Edw590/Linear-30V-3A-DC-PSU/Pictures/Oscilloscope/18 V rail with fan connected; 0.2V, 5ms, AC.jpg

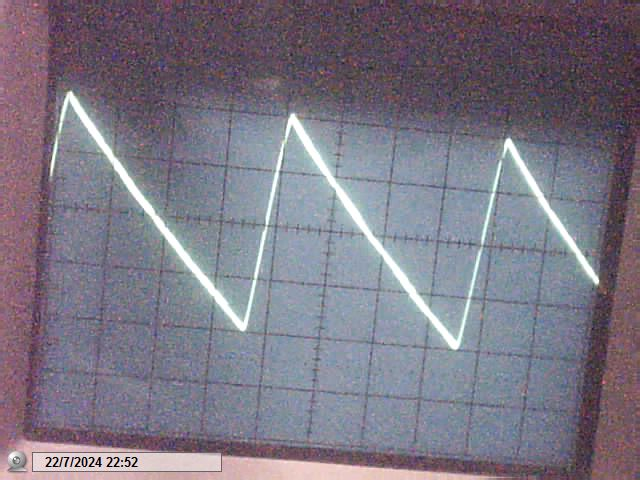
Pictures/Oscilloscope/18 V rail with fan connected; 0.2V, 5ms, AC.jpg
