Edw590/Linear-30V-3A-DC-PSU/Pictures/IMG_20220613_202030_4.jpg

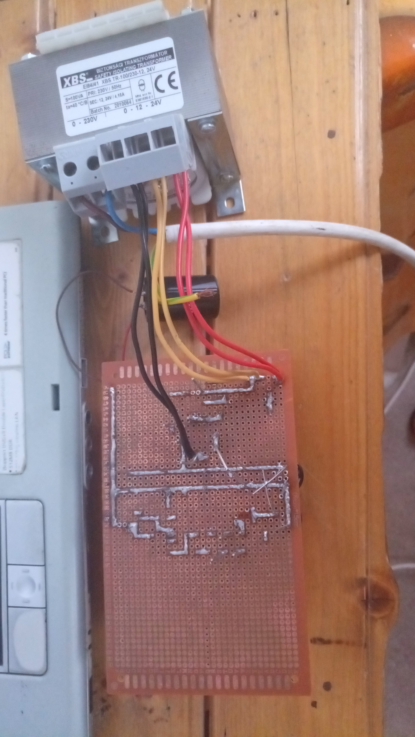
Pictures/IMG_20220613_202030_4.jpg
