Edw590/Linear-30V-3A-DC-PSU/Perfboard drawings/1st board.png

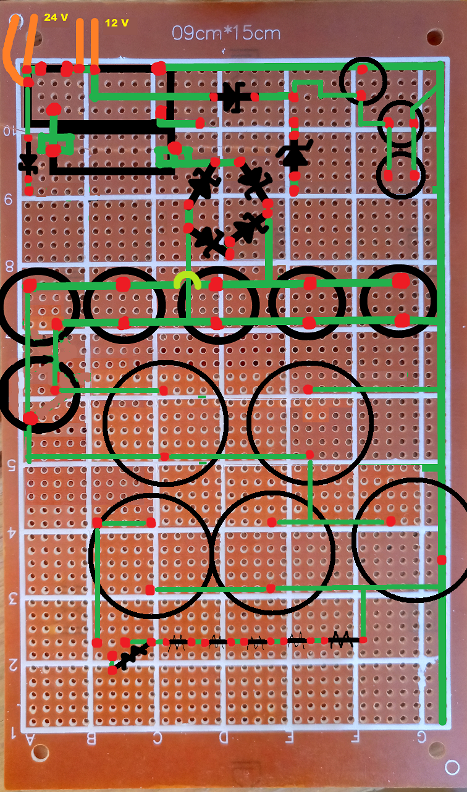
Perfboard drawings/1st board.png
