Edw590/Linear-30V-3A-DC-PSU/Perfboard drawings/2nd board.jpg

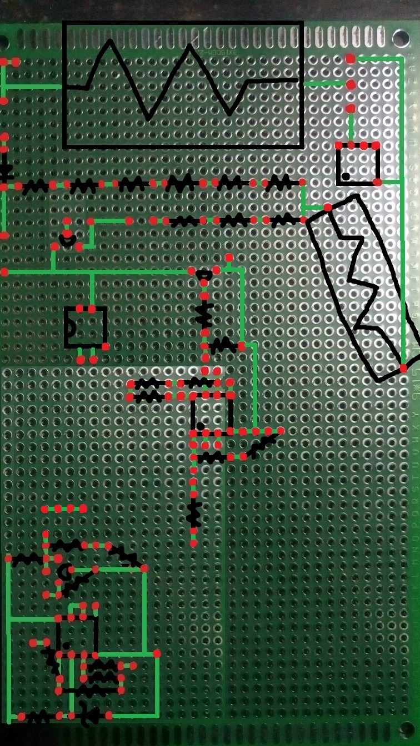
Perfboard drawings/2nd board.jpg
