Edw590/Linear-30V-3A-DC-PSU/Perfboard drawings/IMG_20240725_204748_0.jpg

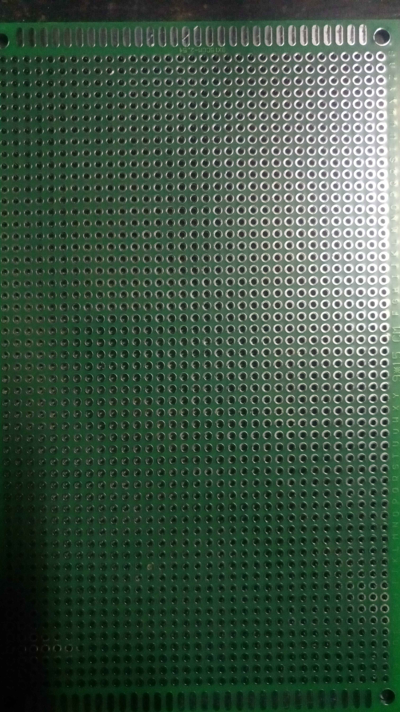
Perfboard drawings/IMG_20240725_204748_0.jpg
