Edw590/Linear-30V-3A-DC-PSU/Pictures/PSU after drilling.jpg

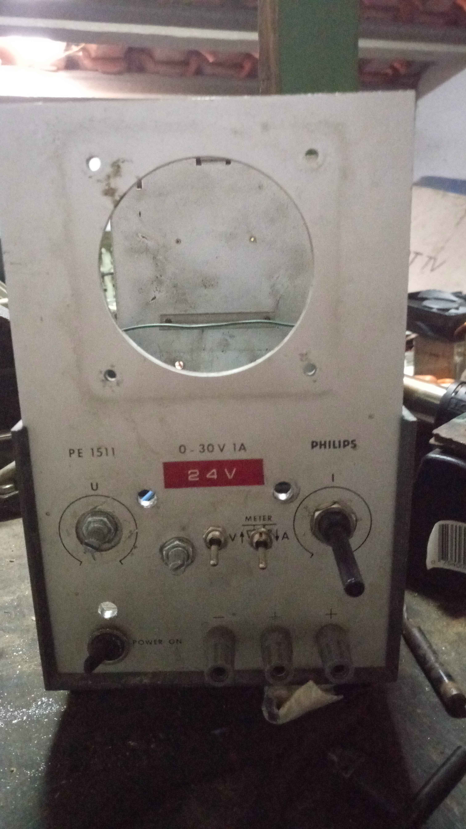
Pictures/PSU after drilling.jpg
