Edw590/Linear-30V-3A-DC-PSU/Pictures/PSU.jpg

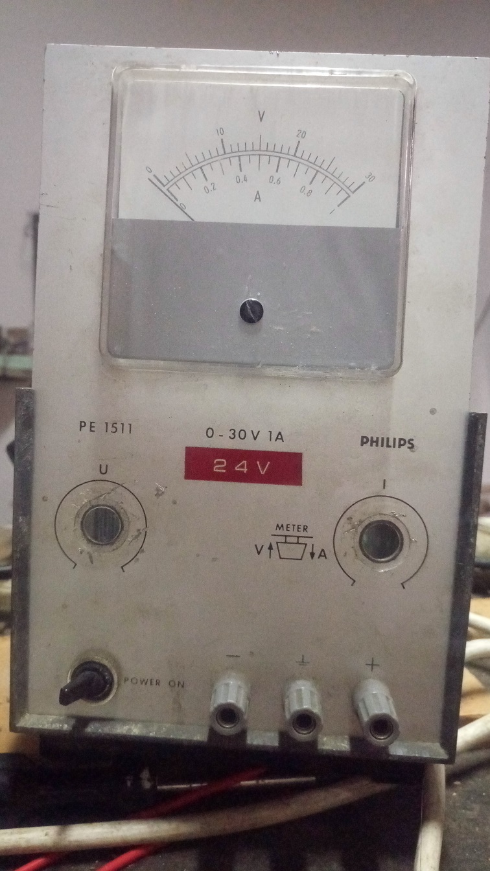
Pictures/PSU.jpg
