Edw590/Linear-30V-3A-DC-PSU/Relay test.asc

R1: res; 1k
RelS1: sw; SwNC
RelS2: sw; SwNO
V1: voltage; SINE(0 12 50)
V2: voltage; SINE(0 12 50)
V3: voltage; PULSE(0 15 0 0 0 0.001 0.002)
Named nets: 0, OUT, IN++, IN+, Comp
Relay
NC
NO
Relay
.tran 100m
; For the relays
.MODEL SwNO SW(Ron=10m Roff=1000Meg Vt=12 Vh=.5 Lser=10n Vser=.6)
.MODEL SwNC SW(Roff=10m Ron=1000Meg Vt=0.5 Vh=.5 Lser=10n Vser=.6)
