Edw590/Linear-30V-3A-DC-PSU/PSU.asc

C1: polcap; 45m; V=35 Irms=3.355 Rser=0.004 Lser=14.3824n
C2: cap; 10m; V=35
C4: cap; 3m; V=35
D1: schottky; B560C
D2: schottky; B560C
D3: schottky; B560C
D4: schottky; B560C
D5: schottky; B560C
D6: schottky; B560C
D7: diode; 1N4148
D8: zener; UMZ5_1N
D12: zener; BZX84C15L
D13: schottky; B560C
L1: ind2; 270
L2: ind2; 1
L3: ind2; 1
LED1: LED; LXK2-PW14
LED2: LED; LXK2-PW14
LED3: LED; LXK2-PW14
LED4: LED; LXK2-PW14
Q1: npn; TIP33C
Q2: npn; 2N2222
Q3: npn; TIP142
Q4: npn; 2N2222
Q7: npn; 2N2222
R1: res; 0.001
R2: res; 0.001
R2_B: res; 1.2k
R3: res; 2k
R4: res; 20k
R5: res; 10000000Meg
R6: res; 1k
R7: res; 20k
R8: res; 100k
R9: res; 47
R10: res; 1.2k
R11: res; 2k
R12: res; 10k
R13: res; 0.001
R14: res; 1.2k
R15: res; 400k
R16: res; 985
R17: res; 23k
R18: res; 313k
R19: res; 1.2k
R20: res; 1.2k
R21: res; 1.2k
R22: res; 2.45k
R23: res; 1.2k
R24: res; 2k
R25: res; 1.2k
R51: res; 0.001
R_Fan: res; 71
R_Meter1: res; 691
R_Meter2: res; 691
R_Pot1: res; 20k
R_Pot2_1: res; 10k
R_Pot2_2: res; 0
R_Pot3: res; 2.5k
RelS1: sw; SwNO
RelS2: sw; SwNC
RelS5: sw; SwNC
RelS6: sw; SwNO
RL1: res; 25
RL2: res; 200
Rsense: res; 0.1
U1: LM358_AB
U2: LM358_AB
U3: LM358_AB
U4: LM358_TI; LM6171A/NS
U5: LM358_AB
U6: LM358_AB
U7: LM317-1
U8: TL431
U9: LM358_TI; LM6171A/NS
V1: voltage; SINE(0 325.57 50); AC 230 0; Rser=0.1
V2: voltage; PULSE(12.5 0 0 0 0 0.1 0.2)
V3: voltage; SINE(0 10 500 0 0 1); Rser=0.1
Named nets: 0, IN+, OUT+, CmpOut1, IN-, +15V, +18V, +5V, Vref, CmpOut2, +31V, VrefUVP, Vunreg, OUT-
.tran 0.25
K1 L1 L2 L3 1
; For the relays
.MODEL SwNO SW(Ron=10m Roff=1000Meg Vt=12 Vh=.5 Lser=10n Vser=.6)
.MODEL SwNC SW(Roff=10m Ron=1000Meg Vt=0.5 Vh=.5 Lser=10n Vser=.6)
**************************************
*      Model Generated by MODPEX     *
*Copyright(c) Symmetry Design Systems*
*         All Rights Reserved        *
*    UNPUBLISHED LICENSED SOFTWARE   *
*   Contains Proprietary Information *
*      Which is The Property of      *
*     SYMMETRY OR ITS LICENSORS      *
*    Modeling services provided by   *
* Interface Technologies www.i-t.com *
**************************************
.SUBCKT TIP142 1 2 3
* Model generated on Feb  8, 2004
* Model format: PSpice
* Darlington macro model
* External node designations
* Node 1 -> Collect
* Node 2 -> Base
* Node 3 -> Emitter
Q1 1 2 4 qmodel
Q2 1 4 3 q1model 19.6725
D1 3 1 dmodel
R1 2 4 8000
R2 4 3 40
* Default values used in dmodel
*   EG=1.11 TT=0 BV=infinite
.MODEL dmodel d
+IS=1e-12 RS=10 N=1 XTI=3
+CJO=0 VJ=0.75 M=0.33 FC=0.5
.MODEL qmodel npn
+IS=2.92836e-16 BF=233.76 NF=1.2 VAF=1000
+IKF=0.222129 ISE=4.61322e-11 NE=2.48158 BR=1.89854
+NR=0.75 VAR=168.458 IKR=0.108495 ISC=9.99999e-14
+NC=2.00001 RB=7.90758 IRB=0.2 RBM=7.90758
+RE=0.275456 RC=1.42279 XTB=0.232595 XTI=3.02293 EG=1.206
+CJE=1e-11 VJE=0.75 MJE=0.33 TF=1e-09
+XTF=1 VTF=10 ITF=0.01 CJC=1.67157e-09
+VJC=0.95 MJC=0.23 XCJC=0.9 FC=0.5
+TR=1e-07 PTF=0 KF=0 AF=1
.MODEL q1model npn
+IS=2.92836e-16 BF=233.76 NF=1.2 VAF=1000
+IKF=0.222129 ISE=4.61322e-11 NE=2.48158 BR=1.89854
+NR=0.75 VAR=168.458 IKR=0.108495 ISC=9.99999e-14
+NC=2.00001 RB=7.90758 IRB=0.2 RBM=7.90758
+RE=0.275456 RC=1.42279 XTB=0.232595 XTI=3.02293 EG=1.206
+CJE=1e-11 VJE=0.75 MJE=0.33 TF=1e-09
+XTF=1 VTF=10 ITF=0.01 CJC=0
+VJC=0.95 MJC=0.23 XCJC=0.9 FC=0.5
+TR=1e-07 PTF=0 KF=0 AF=1
.ENDS
Relay
NTCR1
Diode here to protect from the coil's back "infinite" EMF
NC
NO
Undervoltage protection (also SCP)
18 - 5 = 13 V --> Fan voltage
Unregulated module
*//////////////////////////////////////////////////////////////////////
* (C) National Semiconductor, Inc.
* Models developed and under copyright by:
* National Semiconductor, Inc.  
*/////////////////////////////////////////////////////////////////////
* Legal Notice: This material is intended for free software support.
* The file may be copied, and distributed; however, reselling the 
*  material is illegal
*////////////////////////////////////////////////////////////////////
* For ordering or technical information on these models, contact:
* National Semiconductor's Customer Response Center
*                 7:00 A.M.--7:00 P.M.  U.S. Central Time
*                                (800) 272-9959
* For Applications support, contact the Internet address:
*  Appshelp@galaxy.nsc.com
*/////////////////////////////////////////
*LM6171A Operational Amplifier Macro-Model
*/////////////////////////////////////////
*
*Connections       non-inverting input
*                  | inverting input
*                  | |  positive power supply
*                  | | |  negative power supply
*                  | | | |  output
*                  | | | | |
.SUBCKT LM6171A/NS 3 2 4 5 6
* CAUTION:  SET .OPTIONS GMIN=1E-16 TO CORRECTLY MODEL INPUT BIAS CURRENT.
* Features:
* +/-15V Operation
* Unity Gain Stable
* Offset voltage (max) =             3mV
* Gain-bandwidth product =           100 MHz 
* Supply current =                   2.5mA
* Slew rate =                        3600V/uS
* Open Loop gain =                   90dB
********************************************************************
EOX 120 10 31 32 2.0
RCX 120 121 1K
RDX 121 10 1K
RBX 120 122 1K
GOS 10 57 122 121 1.0
RVOS 31 32 1K
RINB 2 18 1000
RINA 3 19 1000
DIN1 5 18 DMOD2
DIN2 18 4 DMOD2
DIN3 5 19 DMOD2
DIN4 19 4 DMOD2
EXX 10 5 17 5 1.0
EEE 10 50 17 5 1.0
ECC 40 10 4 17 1.0
RAA 4 17 100MEG
RBB 17 5 100MEG
ISET 10 24 1e-3
DA1 24 23 DMOD1
RBAL 23 22 1000
ESUPP 22 21 4 5 1.0
VOFF 21 10 -1.25
DA2 24 25 DMOD1
VSENS1 25 26 DC 0
RSET 26 10 1K
CSET 26 10 1e-10
FSET 10 31 VSENS1 1.0
R001 34 10 1K
FTEMP 10 27 VSENS1 1.0
DTA 27 10 DMOD2
DTB 28 29 DMOD2
VTEMP 29 10 DC 0
ECMR 38 10 11 10 1.0
VCMX 38 39 DC 0
RCM2 41 10 1MEG
EPSR 42 10 4 10 1.0
CDC1 43 42 10U
VPSX 43 44 DC 0
RPSR2 45 10 1MEG
FCXX 57 10 VCXX 100
DCX1 98 97 DMOD1
DCX2 95 94 DMOD1
RCX1 99 98 100
RCX2 94 99 100
VCXX 99 96 DC 0
ECMX 96 10 11 10 1.0
DLIM1 52 57 DMOD1
DLIM2 57 51 DMOD1
ELIMP 51 10 26 10 99.3
GDM 10 57 3 2 1
C1 58 59 1e-10
DCLMP2 59 40 DMOD1
DCLMP1 50 59 DMOD1
RO2 59 10 1K
GO3 10 71 59 10 1
RO3 71 10 1
DDN1 73 74 DMOD1
DDN2 73 710 DMOD1
DDP1 75 72 DMOD1
DDP2 71 720 DMOD1
RDN2 710 71 100
RDP 720 72 100
VOOP 40 76 DC 0
VOON 77 50 DC 0
QNO 76 73 78 NPN1
QNP 77 72 79 PNP1
RNO 78 81 1
RPO 79 81 1
VOX 86 6 DC 0
RNT 76 81 100MEG
RPT 81 77 1MEG
FX 10 93 VOX 1.0
DFX1 93 91 DMOD1
VFX1 91 10 DC 0
DFX2 92 93 DMOD1
VFX2 10 92 DC 0
FPX 4 10 VFX1 1.0
FNX 10 5 VFX2 1.0
RAX 122 10 MRAX 1.006000e+03
.MODEL MRAX RES (TC1=-1.1e-05)
FIN1 18 5 VTEMP 0.985
FIN2 19 5 VTEMP 1.015
CIN1 2 10 1e-12
CIN2 3 10 1e-12
RD1 18 11 2.45e+06
RD2 19 11 2.45e+06
RCM 11 10 3.8775e+07
FCMR 10 57 VCMX 3.16228
FPSR 10 57 VPSX 63.2456
RSLOPE 4 5 33333.3
GPWR 4 5 26 10 0.0016
ETEMP 27 28 32 33 0.178427
RIB 32 33 MRIB 1K
.MODEL MRIB RES (TC1=0.00389579)
RISC 33 34 MRISC 1K
.MODEL MRISC RES (TC1=-0.002)
RCM1 39 41 10
CCM 41 10 2.65258e-11
RPSR1 44 45 100
CPSR 45 10 1.59155e-10
ELIMN 10 52 26 10 91.8926
RDM 57 10 23.5073
C2 57 10 4.78743e-11
ECMP 40 97 26 10 2
ECMN 95 50 26 10 2
G2 58 10 57 10 0.00378
R2 58 10 11.254
GO2 59 10 58 10 35
EPOS 40 74 26 10 1.4
ENEG 75 50 26 10 1.5
GSOURCE 74 73 33 34 0.00135
GSINK 72 75 33 34 0.00135
ROO 81 86 13
.MODEL DMOD1 D
*-- DMOD1 DEFAULT PARAMETERS
*IS=1e-14 RS=0 N=1 TT=0 CJO=0
*VJ=1 M=0.5 EG=1.11 XTI=3 FC=0.5
*KF=0 AF=1 BV=inf IBV=1e-3 TNOM=27
.MODEL DMOD2 D  (IS=1e-17)
*-- DMOD2 DEFAULT PARAMETERS
*RS=0 N=1 TT=0 CJO=0
*VJ=1 M=0.5 EG=1.11 XTI=3 FC=0.5
*KF=0 AF=1 BV=inf IBV=1e-3 TNOM=27
.MODEL NPN1 NPN (BF=100 IS=1e-15)
*-- NPN1 DEFAULT PARAMETERS
*NF=1 VAF=inf IKF=inf ISE=0 NE=1.5
*BR=1 NR=1 VAR=inf IKR=inf ISC=0
*NC=2 RB=0 IRB=inf RBM=0 RE=0 RC=0
*CJE=0 VJE=0.75 MJE=0.33 TF=0 XTF=0
*VTF=inf ITF=0 PTF=0 CJC=0 VJC=0.75
*MJC=0.33 XCJC=1 TR=0 CJS=0 VJS=0.75
*MJS=0 XTB=0 EG=1.11 XTI=3 KF=0 AF=1
*FC=0.5 TNOM=27
.MODEL PNP1 PNP (BF=100 IS=1e-15)
*-- PNP1 DEFAULT PARAMETERS
*NF=1 VAF=inf IKF=inf ISE=0 NE=1.5
*BR=1 NR=1 VAR=inf IKR=inf ISC=0
*NC=2 RB=0 IRB=inf RBM=0 RE=0 RC=0
*CJE=0 VJE=0.75 MJE=0.33 TF=0 XTF=0
*VTF=inf ITF=0 PTF=0 CJC=0 VJC=0.75
*MJC=0.33 XCJC=1 TR=0 CJS=0 VJS=0.75
*MJS=0 XTB=0 EG=1.11 XTI=3 KF=0 AF=1
*FC=0.5 TNOM=27
.ENDS
*$
Regulator module
Must be a voltage source for some reason,
not the CmpOut signal
For noise
NC
NO
Relay
8R
Winding switcher circuit
Overcurrent protection (OCP)
Vref<->OUT regulator
"-M" means missing in the physical circuit
*SYM=SCR
*SRC=2N5064;2N5064;SCRs;TECCOR; 200V 0.8A 
.SUBCKT 2N5064   1 2 3
*    TERMINALS:  A G K
QP  6 4 1  POUT OFF
QN  4 6 5  NOUT OFF
RF  6 4    400K
RR  1 4    267K
RGK 6 5    80
RG  2 6    9.09
RK  3 5    0.112
DF  6 4    ZF
DR  1 4    ZR
DGK 6 5    ZGK
.MODEL ZF   D (IS=3.2E-16 IBV=100U BV=200)
.MODEL ZR   D (IS=3.2E-16 IBV=100U BV=200)
.MODEL ZGK  D (IS=3.2E-16 IBV=100U BV=5)
.MODEL POUT PNP (IS=320F BF=1 CJE=402P TF=102U)
.MODEL NOUT NPN (IS=320F BF=100 RC=0.45 CJE=2.01N CJC=402P TF=3.74U)
.ENDS
1N5338B
BDY20
Button (to force disable the
protection after it's triggered)
Switch here
.MODEL TIP33C npn
+IS=1e-09 BF=2530.91 NF=0.026029 VAF=10
+IKF=0.0647102 ISE=1.00058e-09 NE=1.836 BR=0.1
+NR=1.5 VAR=100 IKR=0.647102 ISC=1.00058e-09
+NC=1.45279 RB=6.98719 IRB=6.81966 RBM=0.001
+RE=0.0001 RC=0.0636828 XTB=15.7688 XTI=1
+EG=1.05 CJE=3.26476e-10 VJE=0.446174 MJE=0.464223
+TF=2.062e-09 XTF=15.0842 VTF=25.7317 ITF=0.001
+CJC=3.07593e-10 VJC=0.775484 MJC=0.476498 XCJC=0.750493
+FC=0.796407 CJS=0 VJS=0.75 MJS=0.5
+TR=1e-07 PTF=0 KF=0 AF=1
LM358
Switch to choose between position R_Meter1 or R_Meter2
