Edw590/Linear-30V-3A-DC-PSU/A2.asc

C1: cap; 470µ
C1_A: polcap; 40m; V=50 Irms=3.355 Rser=0.004 Lser=14.3824n mfg="Würth Elektronik" pn="860010683032 WCAP-ATG8 22x41" type="Al electrolytic"
C2: cap; 470µ
C3: cap; 470µ
C4: cap; 470µ
D1: schottky; RB095T-90
D2: schottky; RB095T-90
D3: schottky; RB095T-90
D4: schottky; RB095T-90
D5: zener; 1N750
D6: zener; 1N750
D7: diode; 1N4148
D8: schottky; RB095T-90
D10: diode; 1N4148
D11: zener; UMZ5_1N
D12: zener; MMBZ6V8ALY
D13: schottky; RB095T-90
L1: ind2; 367.36
L2: ind2; 1
L3: ind2; 1
NTCR1: ntc_resistor; R0=8
Q1: npn; BC547B
Q1_B: npn; TIP41C
Q2: npn; BC547B
Q2_B: npn; 2N2222
Q3: npn; TIP41C
Q3_B: npn; 2N2222
Q4: npn; TIP41C
Q5: npn; TIP41C
Q6: npn; TIP41C
Q7: npn; TIP41C
R1: res; 0.001
R1_Pot: res; 20k
R2: res; 0.001
R2_B: res; 800
R2_Pot: res; 800
R3: res; 2k
R3_B: res; 3.9k
R4: res; 20k
R4_B: res; 860
R5: res; 10000000Meg
R5_B: res; 0.36
R6: res; 20k
R6_B: res; 0.90
R7: res; 25
R7_B: res; 1k
R8: res; 20k
R8_B: res; 10k
R9: res; 20k
R10: res; 20k
R11: res; 40k
R12: res; 100m
R13: res; 100m
R14: res; 100m
R15: res; 100m
R16: res; 100m
R17: res; 100m
R18: res; 0.001
R22: res; 7
R_Fan: res; 71
RelS1: sw; SwNO
RelS2: sw; SwNC
RelS3: sw; SwNC
RelS4: sw; SwNO
Rout: res; 0.001
S3: sw; SwNO
U1: LM358_TI
U2: LM358_TI
U4: tlv431
V1: voltage; SINE(0 325.57 50); AC 230 0; Rser=0.1
V3: voltage; SINE(0 10 5000); Rser=0.1
Named nets: 0, V637, V638, V639, Vunreg, IN+, OUT, CmpOut, IN-, +16V, +34V, +5V, ShortDetec, +17V, +1.24V
.tran 0.35
K1 L1 L2 L3 1
; For the relays
.MODEL SwNO SW(Ron=10m Roff=100Meg Vt=3 Vh=-.5 Lser=10n Vser=.6)
.MODEL SwNC SW(Roff=10m Ron=100Meg Vt=3 Vh=-.5 Lser=10n Vser=.6)
**************************************
*      Model Generated by MODPEX     *
*Copyright(c) Symmetry Design Systems*
*         All Rights Reserved        *
*    UNPUBLISHED LICENSED SOFTWARE   *
*   Contains Proprietary Information *
*      Which is The Property of      *
*     SYMMETRY OR ITS LICENSORS      *
*    Modeling services provided by   *
* Interface Technologies www.i-t.com *
**************************************
.SUBCKT TIP142 1 2 3
* Model generated on Feb  8, 2004
* Model format: PSpice
* Darlington macro model
* External node designations
* Node 1 -> Collect
* Node 2 -> Base
* Node 3 -> Emitter
Q1 1 2 4 qmodel
Q2 1 4 3 q1model 19.6725
D1 3 1 dmodel
R1 2 4 8000
R2 4 3 40
* Default values used in dmodel
*   EG=1.11 TT=0 BV=infinite
.MODEL dmodel d
+IS=1e-12 RS=10 N=1 XTI=3
+CJO=0 VJ=0.75 M=0.33 FC=0.5
.MODEL qmodel npn
+IS=2.92836e-16 BF=233.76 NF=1.2 VAF=1000
+IKF=0.222129 ISE=4.61322e-11 NE=2.48158 BR=1.89854
+NR=0.75 VAR=168.458 IKR=0.108495 ISC=9.99999e-14
+NC=2.00001 RB=7.90758 IRB=0.2 RBM=7.90758
+RE=0.275456 RC=1.42279 XTB=0.232595 XTI=3.02293 EG=1.206
+CJE=1e-11 VJE=0.75 MJE=0.33 TF=1e-09
+XTF=1 VTF=10 ITF=0.01 CJC=1.67157e-09
+VJC=0.95 MJC=0.23 XCJC=0.9 FC=0.5
+TR=1e-07 PTF=0 KF=0 AF=1
.MODEL q1model npn
+IS=2.92836e-16 BF=233.76 NF=1.2 VAF=1000
+IKF=0.222129 ISE=4.61322e-11 NE=2.48158 BR=1.89854
+NR=0.75 VAR=168.458 IKR=0.108495 ISC=9.99999e-14
+NC=2.00001 RB=7.90758 IRB=0.2 RBM=7.90758
+RE=0.275456 RC=1.42279 XTB=0.232595 XTI=3.02293 EG=1.206
+CJE=1e-11 VJE=0.75 MJE=0.33 TF=1e-09
+XTF=1 VTF=10 ITF=0.01 CJC=0
+VJC=0.95 MJC=0.23 XCJC=0.9 FC=0.5
+TR=1e-07 PTF=0 KF=0 AF=1
.ENDS
Notice that put the protections makes the TIP current be stolen and VCE != 0
always (which means, less output voltage, even without an overload).
PS: happens with any of the 2 protections.
Above, a pull-down resistor so that the signal is not floating at t=0
ATTENTION: as said on Discord, there can be drifts in the reference voltage depending
on the ripple from the unregulated supply. Check if with the ripple being at most 3 V it's too
bad or if we really must use an IC as a fixed DC PSU for the comparator.
Note: say on the DOCX that you changed your mind because of this.
Relay
NTCR1
Diode here to protect from the coil's back "infinite" EMF
NC
NO
Relay
NC
NO
Mechanical switch to toggle short-circuit protection
So no need for Foldback protection anymore - protection for overcurrent only
Try to put a switch here too, and glue to the upper one so that both are controlled at the
same time. This way, the relay is bypassed and also disabled (why wear it out if it's not being
used anyway?).
Put this in the unregulated part - cut the maximum power possible
SCHMITT TRIGGER NEEDED HERE!!!!!!!!!!!
This is just on paper. In practice, the 17 V rail must be given, as it's more stable than
the 5 V one (depends on the fan) - also because in practice, the LMV431 will be
used, which can withstand up to 35 V (recommended 30 V).
EDIT: unless the 5 V rail is more stable than the 17 V one (check with the scope, not here).
Find another transistor with lower VBE (this one is 1.7 V...), and keep the gain high
(no darlington pair needed then, which would get another VBE into account).
7.5 Ohm minimum (30 V/4 A)
Except voltage gets lowered. Test manually at 4 A.
Currently (2022-10-27): 7 Ohm
The relation of this is not linear!!! FIX THAT
You can't put 0 on the bottom. The potentiometer must be on one side only.
Else, weird relation (try to make an equation just for curiosity of the relation?)
.MODEL TIP41C npn
+IS=7.55826e-11 BF=260.542 NF=1.11221 VAF=100
+IKF=0.526814 ISE=1e-08 NE=2.18072 BR=26.0542
+NR=1.5 VAR=1000 IKR=3.54059 ISC=1e-08
+NC=1.63849 RB=4.56157 IRB=0.1 RBM=0.1
+RE=0.0162111 RC=0.0810556 XTB=0.1 XTI=1
+EG=1.206 CJE=1.93296e-10 VJE=0.4 MJE=0.259503
+TF=1e-08 XTF=4.06972 VTF=7.1157 ITF=0.001
+CJC=1.09657e-10 VJC=0.730921 MJC=0.23 XCJC=0.803085
+FC=0.8 CJS=0 VJS=0.75 MJS=0.5
+TR=9.01013e-08 PTF=0 KF=0 AF=1
* Model generated on Dec 27, 2003
* Model format: PSpice
