Edw590/Linear-30V-3A-DC-PSU/(commit log)

2024-03-01 Match between LTspice and actual circuit
    Now both places match. There are components missing which have "-M"
    appended to them on LTspice.
    The circuit on LTspice should be ready to be continued to part B, the
    regulated part of the PSU.
2024-03-05 Regulator module development begun
    List of changes:
    - Parallel of 3 capacitors removed and repurposed to the 17 and 34 V
    rails.
    - More components missing noted down.
    - Regulator module development begun and some components are now
    properly placed.
2024-03-08 Overload and short-circuit protection added
    List originf changes:
    - Circuit works with LTspice 24 (the power diodes weren't supported in
    the new one).
    - Overcurrent protection added with variable limit chosen by a
    potentiometer.
    - Short-circuit protection made up by me added. It checks if the output
    voltage is below half the reference voltage and if so, it turns off
    the output. It needs a switch to reset the protection.
    - The potentiometer that chooses the output voltage is now on the
    reference voltage instead of on the output. This removes the
    possibility of current flowing through the voltage divider on the
    output - now there's none. This also means the TLV431 now goes from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
2024-03-08 Power diodes changed to better match bought ones
2024-03-09 Test with winding relay switching
2024-03-09 Short-circuit protection improved, relays fixed
    - Short-circuit protection improved to now using a relay instead of
    stopping the power transistors (useful in case they get burned and
    shorted). It also detects now at 2/3 of Vref instead of 1/2.
    - Fixed the relays not working and now both can be tested. One of them
    needs a voltage source on the simulation for some reason, but the
    overall result is that it works. The 2nd one works perfectly.
    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
2024-03-09 Short-circuit protection has choosable level / off
    Now there's a potentiometer choosing the short-circuit protection level.
    It can also be turned off and so there's no short-circuit protection.
2024-03-09 Almost fixed winding switch supply rail
    Can't use the +34V one because LTspice doesn't like it. I'll try again
    with more changes to the circuit. Maybe they make LTspice like
    simulating this.
2024-03-09 Schmitt trigger added to the winding switcher
    Supposedly it'll go high at 14+1.7 V and will go low at 14-1.7 V. Needs
    physical testing to be sure but should be working.
2024-03-10 2nd relay now is always on GND by default
    This protects the load in case there's a malfunction in the supply - the
    load will have no power by default.
    There's also a pull-up resistor on the SC protection because of that
    (explanation is on the schematic).
    Also changed the noise voltage source to 500 Hz instead of 5 kHz,
    because it's more realistic.
2024-03-10 Maximum current changed to 2.88 A
    After reviewing the datasheet of the transformer, it can take up to 2.95
    A on both windings after rectification. So the maximum was changed to a
    bit below that.
2024-03-10 Schmitt trigger hysteresis width changed to 1.7 V
2024-03-11 Changed NTC resistor and LM358 connected to +34V
2024-03-12 Undo connect LM538 to +34V - still causes DefCon 1
2024-03-12 Correct mistaken SCP initial start
    The SCP would start when the circuit would be turned on. That doesn't
    happen anymore now, with the addition of the capacitor C5. The
    explanation is on the DOCX.
2024-03-12 Overvoltage protection added
    If the power transistors get shorted, full voltage will appear on the
    output - this disables the supply in that case.
2024-03-13 SCP and OVP corrected to not rely on a relay
    As explained on Discord, the relay contacts will get welded at such high
    currents in case of OVP, and it's just too slow in both cases (can take
    10ms to switch and apparently that's too long already).
    Instead, the SCP is now stealing the current from the pass transistors,
    and the OVP is using a thyristor to short the output and allow the fuse
    to blow to protect the circuit.
2024-03-14 Schmitt trigger width corrected from 1.7 V to 3.4 V
2024-03-17 Noted LM6171 in 2 places and R to limit LM358 curr
    Now the SCR current is no longer a problem - it's an LM6171 providing
    the current, which can give up to 135 mA and that's more than enough
2024-07-13 Crowbar removed, passive averager added
    - Crowbar circuit removed. I'll let the fuse do its job instead. As I
    was told on Discord, shorted pass transistor is an emergency and the
    supply can't work without it, so just blow the fuse and make the user
    replace the transistor.
    - Added a passive averager to sum the currents from the comparator 1 and
    2 and feed to Q7. This is an analog OR circuit. Any of the protections
    are triggered, the transistor will start conducting.
    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
2024-07-13 Disabled OVP, added LEDs and button
    The Overvoltage Protection is now useless. The protection is now done by
    the fuse itself.
2024-07-13 Added LED to OCP
2024-07-14 Correct LEDs and an LED direction
2024-07-14 Precision Vref added, discharge resistor added
    Now Vref can go down to 0.125 V - with a switch. Precision mode.
    Need for LM6171 removed on the regulator. It's driving a darlington pair
    so no need for a more powerful op amp.
2024-07-14 Overvoltage protection circuit removed
2024-07-14 Replaced 3 diodes by one 15 V Zener
2024-07-17 Add 15 mF cap, add analog meter voltage divider
    15 mF cap on the 34 V rail now, because various parts draw current from
    it, and added a voltage divider necessary for an old analog meter I got
    to show the correct voltage on it
2024-07-18 Added caps discharging circuit instead of resistor
    And it's fast enough to discharge in 2.1 seconds from 30 V to 0 V.
2024-07-18 Removed darlington pair and OCP LED
    The LED was making the OCP minimum be higher. The LM6171 can provide
    enough current to power the BDY20 through the 2.7 A, so no need for a
    darlington pair.
2024-07-19 Some transistors replaced by 2N2222 and TIP33C
    The BC547B has as maximum collector current of 100 mA and I need at
    least 136 mA, so I replaced it by a 2N2222.
    The TIP142 doesn't simulate too well the BDY20 that will be used in the
    actual circuit (VCEsat is too high), so I replaced it by a TIP33C.
2024-07-19 Capacitor removed from the SCP
    Now it's instantaneous - one just needs to be aware it will be triggered
    when the PSU starts or in some other cases. We'll see if I get it back
    there or not.
2024-07-20 Now using TL431 instead of TLV431
    I found a TL431A (1% precision). That's better than the LMV431CZ I was
    gonna get (1.5% precision). So now the supposed minimum voltage is 2.5
    V instead of 1.24 V (except it can go lower with the voltage divider)
2024-07-20 New OCP able to limit from 0 mA onwards
    Only problem is I don't have a 1.2k potentiometer, so I'll have to use a
    1k one and have a 240 Ohm resistor in series with it - which limits the
    minimum current limiting to around 500 mA. Could be worse (has been).
2024-07-21 Vref calibrated to 30 V max now
2024-07-21 Winding switcher circuit removed from perfboard
2024-07-21 OCP changed to another new one, 50mR Ohm to 0R1
    This new one can still go down to 0 mA. The other one needed a negative
    supply of 1-3 V to power the negative rail of the op amp. This new one
    doesn't need that.
    I also changed the sense resistor to 0.1 Ohm instead of 0.05 Ohm.
2024-07-21 Some LM6171 instances replaced by LM358
    Haven't seen any Def Con 1 so they should work. If they don't, I'll
    switch back to LM6171 to stop them as I did before.
2024-07-22 Perfboard synced with physical circuit
2024-07-22 LTspice circuit synced with physical circuit
2024-07-23 Rails voltage increased to match physical trafo
    The transformer outputs 19 V and 38 V apparently. Not what's on the
    specs. So I changed that on LTspice and now more things have to be
    changed too because some components can't handle more than 32 V.
    The output is now on 29.3 V though. That needs to be fixed.
2024-07-23 Mark all wires solder points
2024-07-23 Change Vref rail to 34 V
2024-07-23 Added part of +31V rail to perfboard
    Also drew diodes where they were instead of just lines
2024-07-24 Add 10 mF capacitors to perfboard and resistor
2024-07-24 Removed 34 V rail and reverse polarity diode
2024-07-24 Correct resistors positioning
2024-07-24 Fix Def Con 1 and mark diode as missing
2024-07-25 Sync LTspice circuit with physical circuit
2024-07-26 Add 2nd board picture, still empty
2024-07-26 Update some calculations to address the new 38 V
2024-07-26 OUT+ on winding switcher circuit instead of Vref
2024-07-26 Correct wrong resistor on Vref circuit
2024-07-26 Mark components as not missing and remove 2 wires
2024-07-26 Add winding switcher circuit to perfboard
2024-07-26 Add LED to OCP protection
2024-07-27 Add Vref circuit to perfboard
    Also begin adding SCP circuit too (the usage of the upper op amp on the
    lower LM358).
2024-07-27 Add +17V rail diode to perfboard
2024-07-27 Correct the R6 resistors on the perfboard
2024-07-27 Correct resistor placement on the perfboard
2024-07-27 Add current measurement with the analog meter
2024-07-27 Add resistor to limit LED voltage
2024-07-27 Added more circuitry to perfboard
    OCP added, regulator, part of the SCP and meter current measurement
2024-07-28 Correct Vref rail
2024-07-29 Rename LEDs and add LED
2024-07-29 Add pictures of PSU before and after drilling
2024-07-30 Replace R20 by 10k to allow 17 mA to flow to the LED
2024-08-01 Correct Vref rail and add GND point
2025-08-18 Some corrections from the physical circuit
2025-08-24 Remove +31V from U1
    It was making it so that current would flow from base to collector -->
    not ever supposed to happen on an NPN. This was happening because Vunreg
    can be 20 V. So from 30 V to 20 V is how the current would flow.
